FrancisCrickInstitute/Spherical_treadmill/IMG_20221115_132419.jpg

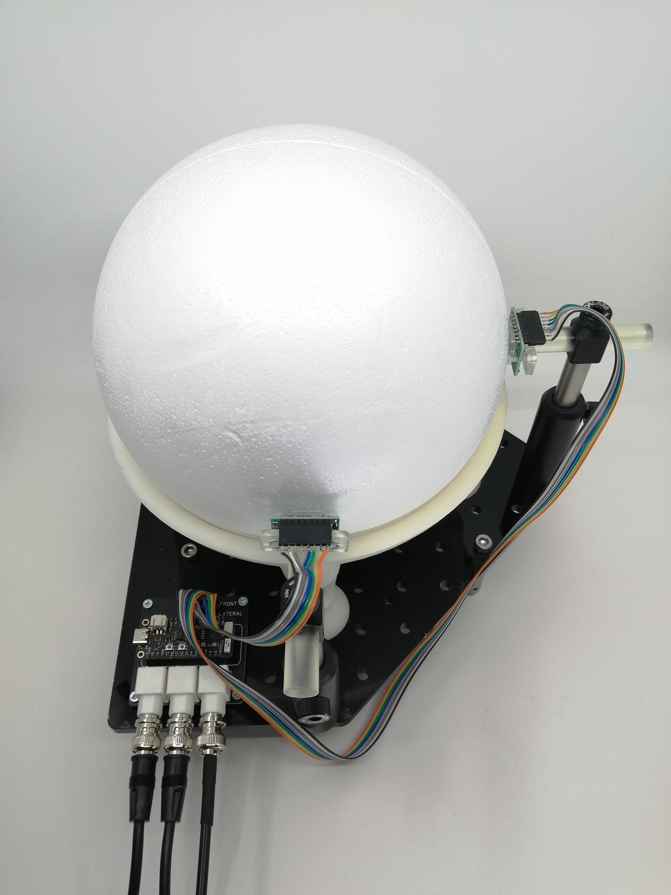
IMG_20221115_132419.jpg
