FrancisCrickInstitute/Spherical_treadmill/README.md

# Spherical_treadmill
