FrancisCrickInstitute/Spherical_treadmill/Spherical treadmill BOM.xlsx

 | Quantiy | Ordering/Manufacturing
Polystirene Ball (20 cm) | 1 | https://www.amazon.co.uk/Glorex-3803-840-Styrofoam-Balls-Styrofoam/dp/B016NEHY0K
Optical sensor (PMW3360) | 2 | https://www.tindie.com/products/jkicklighter/pmw3360-motion-sensor/
Thorlabs RA180_M | 2 | https://www.thorlabs.com/thorproduct.cfm?partnumber=RA180/M
Thorlabs TR75V_M | 2 | https://www.thorlabs.com/thorproduct.cfm?partnumber=TR75V/M
Thorlabs PH75_M | 2 | https://www.thorlabs.com/thorproduct.cfm?partnumber=PH75/M#ad-image-0
ESP32 |  | https://www.adafruit.com/product/4769
Base | 1 | Laser cut
Sensor holder | 2 | 3D printed
Ball holder | 1 | 3D printed (https://ranczlab.github.io/RPM/)
