FrancisCrickInstitute/Spherical_treadmill/Manufacturing files/Electronics/BOM_PCB_PWM3360 Board copy_2022-11-15.csv

ID | Name | Designator | Footprint | Quantity | Manufacturer Part | Manufacturer | Supplier | Supplier Part | Price | Pins
1 | 4.7k | R1,R2,R3,R4,R5,R6 | R0805 | 6 | 0805W8F1801T5E | UniOhm | LCSC | C17398 | 0.002 | 2
2 | MCP4725A0T-E/CH | U1,U2,U3 | SOT-23-6_L2.9-W1.6-P0.95-LS2.8-BR | 3 | MCP4725A0T-E/CH | MICROCHIP | LCSC | C144198 | 2.464 | 6
3 | DOSIN-801-0030 | RF3,RF1,RF2 | BNC-TH_DOSIN-801-0030 | 3 | DOSIN-801-0030 | dosinconn | LCSC | C521204 | 1.177 | 4
4 | Front sensor | H1 | HDR-F-2.54_1X8 | 1 |  |  | LCSC | C225505 | 0.175 | 8
5 | Lateral sensor | H2 | HDR-F-2.54_1X8 | 1 |  |  | LCSC | C225505 | 0.175 | 8
6 | Feather_HUZZAH32 | MS1 | ADAFRUIT_HUZZAH32_MOUNT_0 | 1 |  |  | Adafruit | undefined |  | 28
