FrancisCrickInstitute/Spherical_treadmill/Manufacturing files/Mechanics/PWM3360 holder.stl

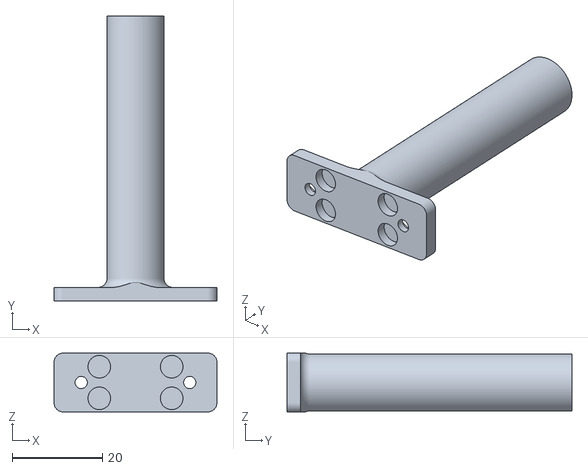
[picture p2: CAD file, 2022-11-15]
Manufacturing files/Mechanics/PWM3360 holder.stl
36.0 x 63.0 x 13.0
