FrancisCrickInstitute/Spherical_treadmill/(list of files, cad)

Other CAD files:
Manufacturing files/Mechanics/Base v2.dwg
Manufacturing files/Mechanics/Base.dwg
Design files/PWM3360 holder.ipt
