FrancisCrickInstitute/Spherical_treadmill/Design files/Schematic_PWM3360 Board V2_2022-11-15.pdf

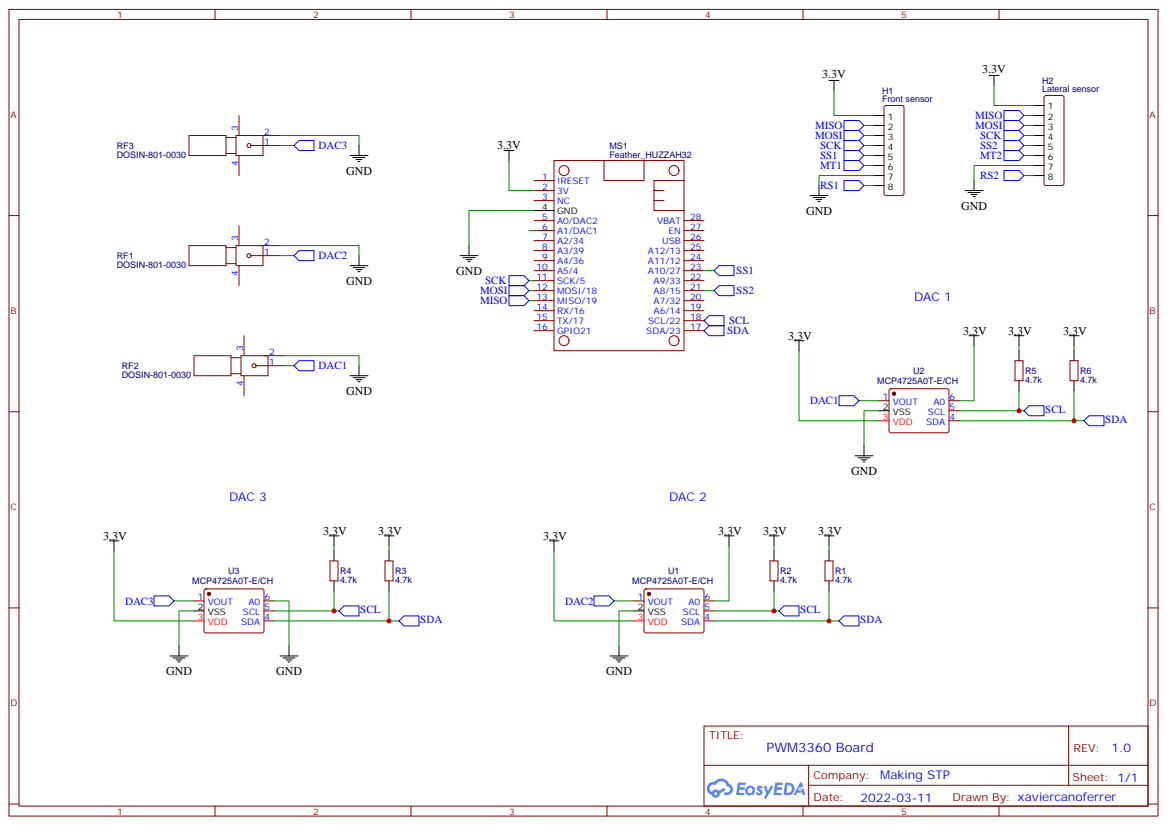
[picture p3: page 1]
